ahmadmadyy/Poppy-Robotic-Arm/RoboticsPoster.pdf

Robotics EDPT 1009
Modeling and Control of Poppy Humanoid Robot Arm used for Teeth-Brushing inspired by Spiderman
Winter 2022

Course Instructors: Dr. Eng. Omar M. Shehata, Dr. Lobna Tarek, Eng. Dalia M. Mamdouh, MSc. And Eng. Mai Mira, MSc.
Ahmed Mady(46-0798) , Amro Abdellatif (46-3027), Marwan Sallam(46-3401) , Mohamad Magdy(46-3493), and Mostafa Kashaf(46-5456), Emails: ahmed.alimady@student.guc.edu.eg, amro.abdellatif@student.guc.edu.eg, marwan.sallam@student.guc.edu.eg, mohamed.elsaidnada@student.guc.edu.eg, mostafa.kashaf@student.guc.edu.eg

Abstract: An open-source Poppy humanoid robotic hand was created in this work to aid in service robotics. The application aimed to brush the teeth by developing a movement sequence for the hand. SIMSCAPE Multibody in SIMULINK and MATLAB is used for the software, while the hardware is designed and implemented in SOLIDWORKS, 3D-printed in PLA+ material. First, the forward position kinematics is obtained by using the DH convention, followed by the inverse position kinematics by Newton Raphson’s numerical method. Both were tested and compared to the actual values obtained from the robot dimensions. Then test trajectory tracking using the equation for a straight line for 2 movements, the first forward and the other backward.

### Hand

Forearm | Upper Arm | Shoulder Arm Connector

Methodology: To obtain the forward and inverse kinematics, the DH convention is obtained.

Results: Testing the forward kinematics function by comparing the real or measured values from the transform sensor in SIMSCAPE to the calculated function and observing a very small error inputting angles
0

, 30

, 45

, 90
: Pseudocode for Inverse Kinematics

Initial guess for the angles
Input difference error
while(error<difference error){
qn+1 = qn – inverse jacobian*forward kinematics Calculate the new error }

Trajectory: 2 trajectories: 1 forward and another backward To maintain continuous motion, the equations of a straight line traversing x=-20.75 cm to -7.774 cm changing only 2 angles, q2 and q4, Ts is the sampling time

q2 range

q4 range
