ahmadmadyy/Poppy-Robotic-Arm/Submission/Spiderman Videos.png

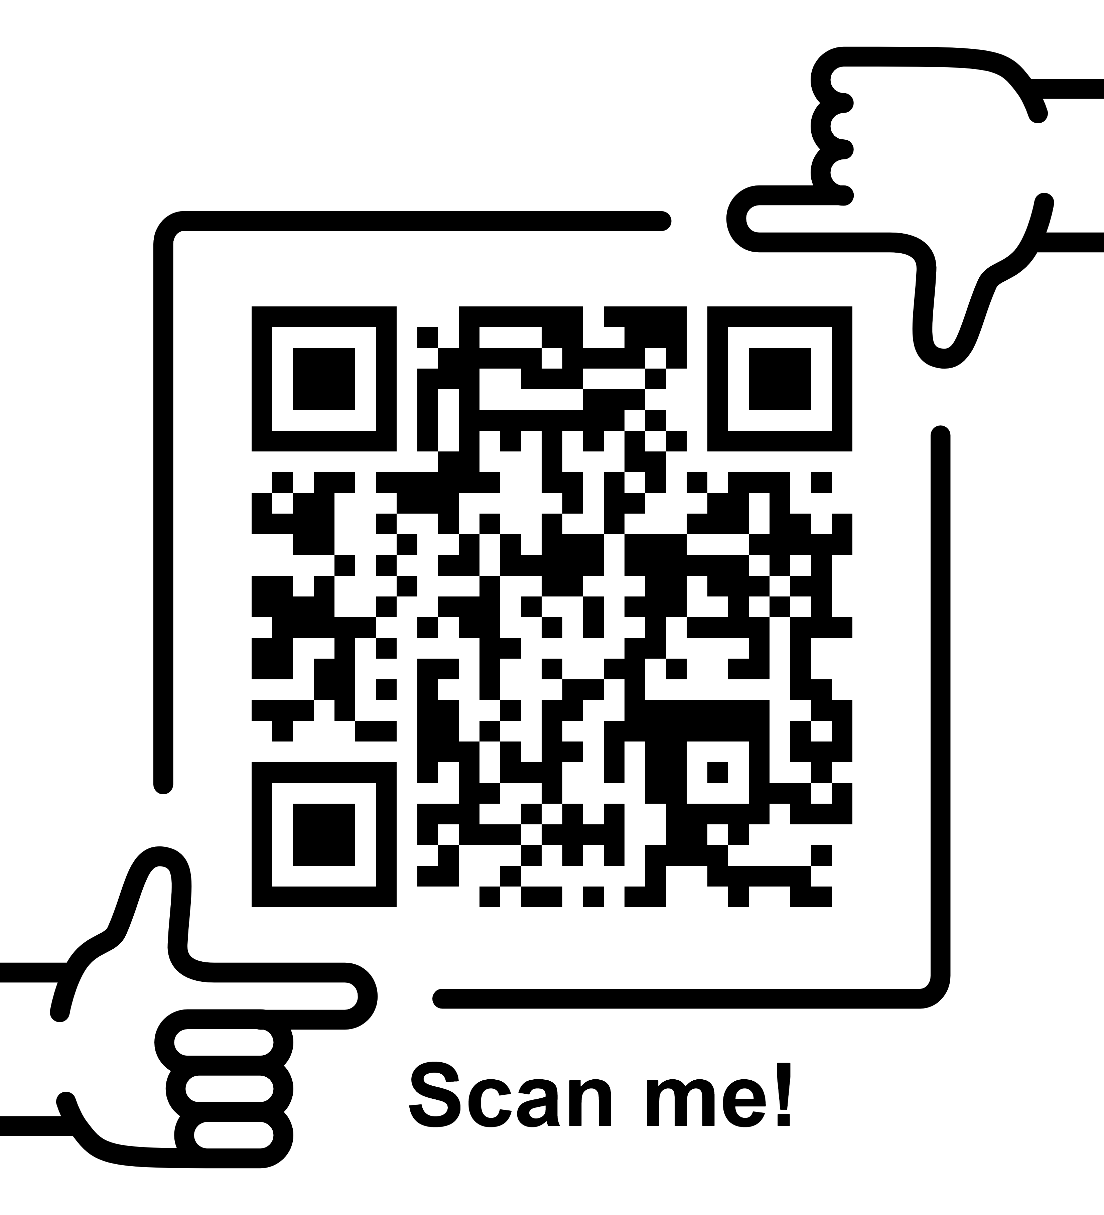
Submission/Spiderman Videos.png
