ahmadmadyy/Poppy-Robotic-Arm/Submission/Simscape_R/Simscape_R/RDS3225 v7 motor - RDS3225 v7.step-1 RDS3225-1.step-1_Default_sldprt.STEP

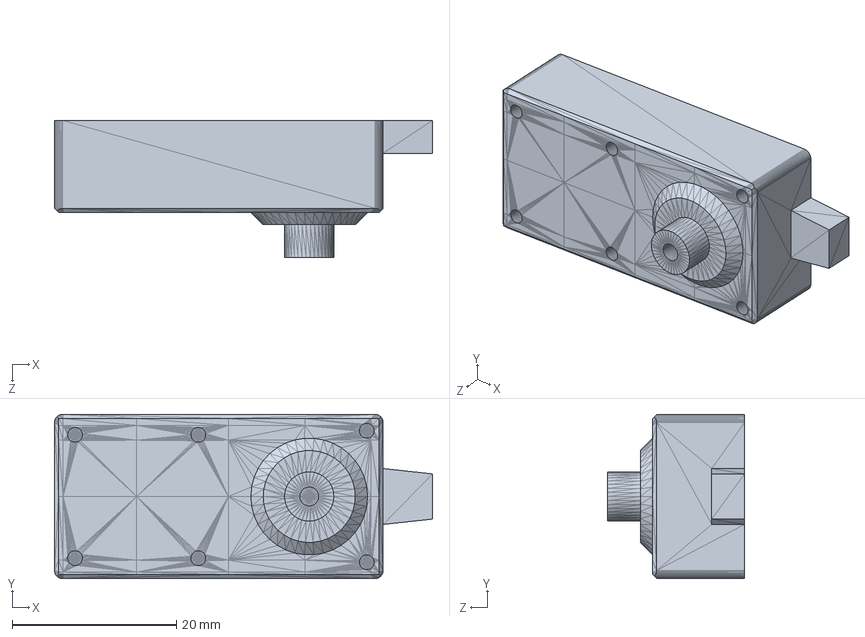
[picture p25: CAD file, 2023-09-10]
Submission/Simscape_R/Simscape_R/RDS3225 v7 motor - RDS3225 v7.step-1 RDS3225-1.step-1_Default_sldprt.STEP
46.0 x 20.0 x 16.7 mm
