ahmadmadyy/Poppy-Robotic-Arm/Submission/Simscape_R/Simscape_R/RDS3225 v7 motor - RDS3225 v7.step-1 RDS3225.step-1_Default_sldprt.STEP

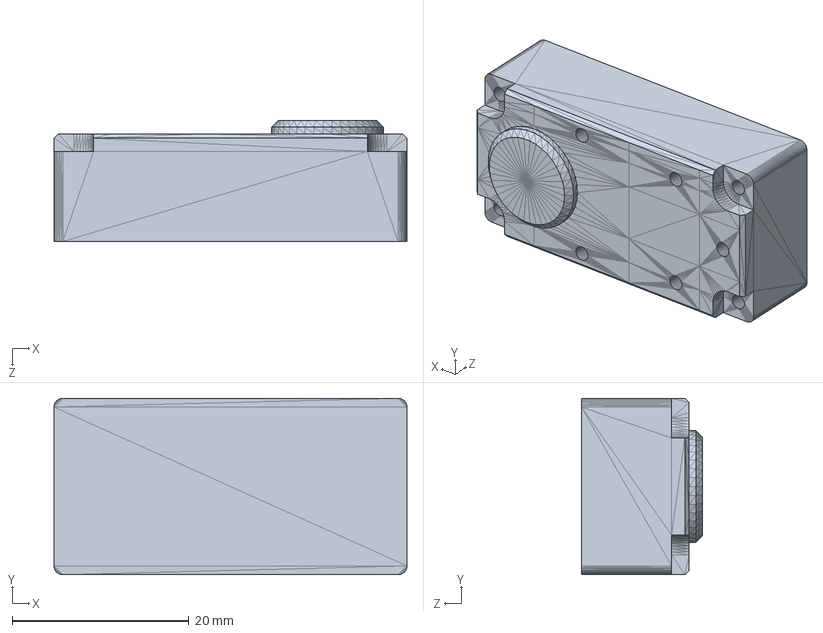
[picture p26: CAD file, 2023-09-10]
Submission/Simscape_R/Simscape_R/RDS3225 v7 motor - RDS3225 v7.step-1 RDS3225.step-1_Default_sldprt.STEP
40.0 x 20.0 x 13.7 mm
