ahmadmadyy/Poppy-Robotic-Arm/Submission/Arduino/Motion/Motion.ino

#include <Servo.h>

Servo myservo1;  
Servo myservo2;
Servo myservo3;
Servo myservo4;

int pos1 = 0;   //CONSTANT   
int pos3 = 15; //90(105) is zero //CONSTANT
int pos2[101] = {119.21,117.75,116.3,114.86,113.44,112.03,110.64,109.26,107.89,106.53,105.19,103.86,102.54,101.23,99.92,98.63,97.35,96.08,94.81,93.55,92.3,91,89.82,88.59,87.36,86.13,84.9,83.68,82.46,81.24,80.02,78.8,77.57,76.35,75.12,73.88,72.64,71.4,70.14,68.88,67.6,66.32,65.02,63.7,62.36,61.01,59.63,58.22,56.78,55.31,53.8,55.29,56.76,58.2,59.6,60.98,62.34,63.68,64.99,66.3,67.58,68.86,70.12,71.38,72.62,73.86,75.1,76.33,77.55,78.78,80,81.22,82.44,83.66,84.88,86.11,87.34,88.57,89.8,91.03,92.28,93.53,94.79,96.06,97.33,98.61,99.9,101.2,102.51,103.84,105.17,106.51,107.87,109.24,110.62,112.01,113.42,114.84,116.27,117.72,119.19};

int pos4[101] = {122.77,121.97,121.15,120.3,119.43,118.54,117.63,116.7,115.75,114.77,113.78,112.77,111.74,110.68,109.61,108.52,107.41,106.28,105.13,103.96,102.77,101.56,100.32,99.07,97.8,96.5,95.19,93.85,92.48,91.1,89.69,88.25,86.79,85.29,83.77,82.22,80.64,79.03,77.38,75.7,73.97,72.2,70.39,68.53,66.62,64.66,62.63,60.54,58.37,56.12,53.77,56.08,58.33,60.5,62.6,64.62,66.59,68.5,70.36,72.17,73.94,75.67,77.35,79,80.62,82.2,83.75,85.27,86.76,88.22,89.66,91.07,91.46,93.82,95.16,96.48,97.78,99.05,100.3,101.54,102.75,103.94,105.11,106.26,107.39,108.5,109.59,110.67,111.72,112.75,113.76,114.76,115.73,116.68,117.61,118.53,119.42,120.28,121.13,121.96,122.76};
void setup() {
  myservo1.attach(9);  
  myservo2.attach(6); 
  myservo3.attach(5); 
  myservo4.attach(3); 
  
  myservo1.write(0);
  myservo2.write(119.21);
  myservo3.write(15);
  myservo4.write(122.77);          
  delay(1000); 
}

void loop() {
  for (int i=0;i<=100;i++)
  { 
    myservo2.write(pos2[i]);  
    myservo4.write(pos4[i]);       
    delay(100);    
  }                 
}
